ikstream/HTW-Smart-Sportswear-Prj-SS2020/Readme.md

# Repository for the Smart Sport Shirt Project

## Dependencies
- TinyGP++ Library
- ESP32 TTGO T-Beam library from espressif

## Components
This Project uses the TTGO T-Beam v1.1

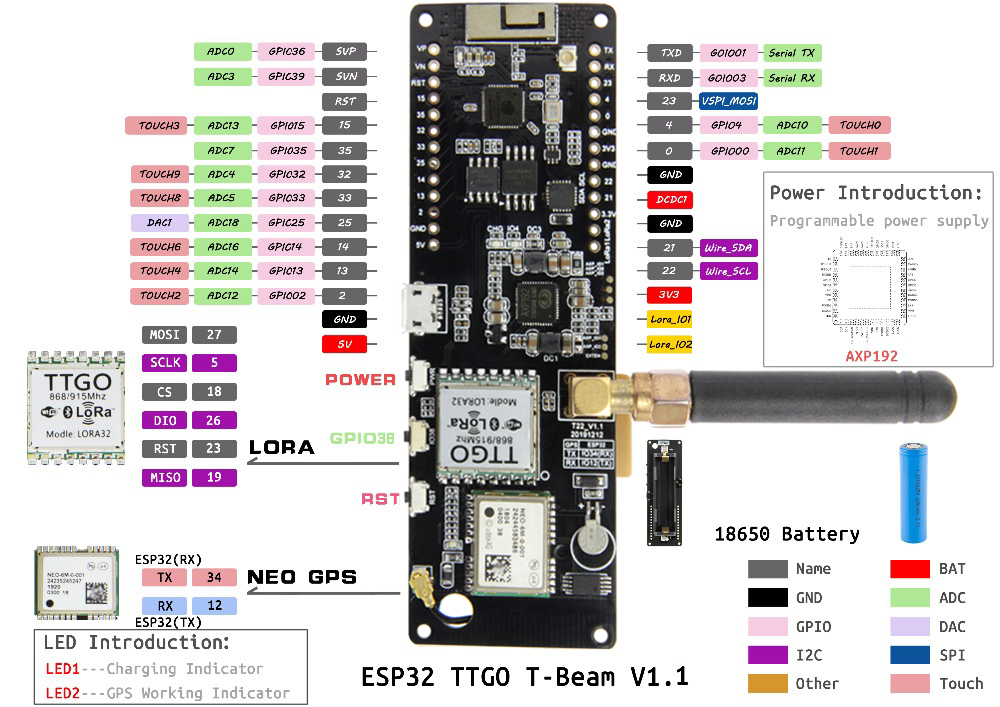
[picture p1: images/ttgo_t-beam_v1_1.jpeg]


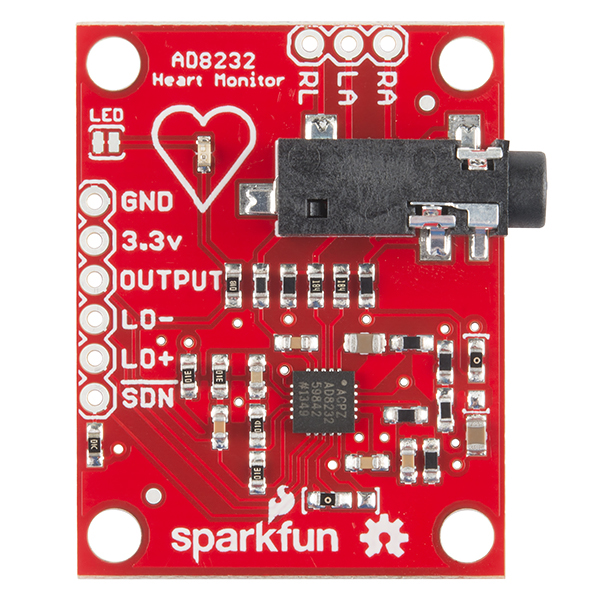
[picture p2: images/AD8232.jpg]


| T-Beam | AD8232 |
| -- 	 | --	  |
| VP 	 | Output |
| 15 	 | LO+	  |
| 35 	 | LO-	  |
| - | SDN |

And a AD8232 ECG Sensor
