ikstream/HTW-Smart-Sportswear-Prj-SS2020/images/test_vs_constructed.png

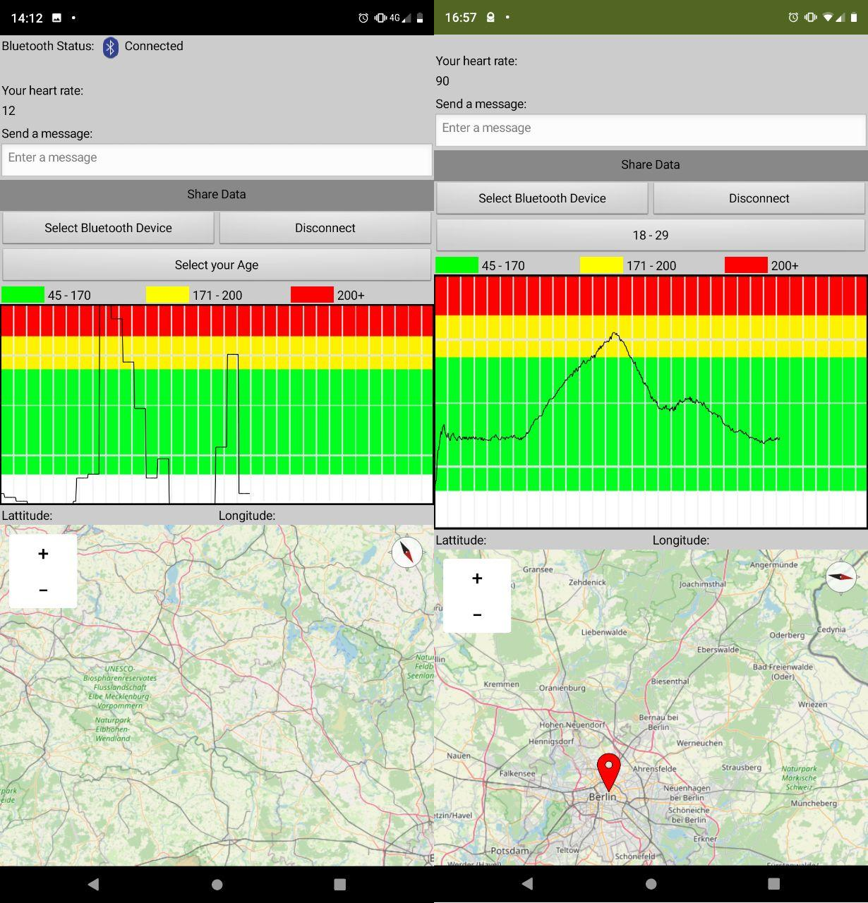
images/test_vs_constructed.png
