ikstream/HTW-Smart-Sportswear-Prj-SS2020/docs/Test_protocolls/Protokoll_Test1.md

Test Protokoll 1

# Test Protokoll 1

### Durchführung
- Schutzfolie wird von EKG-Elektroden entfernt
- AD8232 wird mit Elektroden verbunden
- T-Beam wird angeschlossen
- Test Person legt das Shirt mit Verbauter Elektronik an.
- Elektroden werden leicht angedrückt durch Testperson
- T-Beam wird mit Android App verbunden
- Versuchsperson Joggt für ca 2 Minuten

### Ergebnisse
- Keine Puls Werte angezeigt 
- GPS hat keinen ausreichenden Daten zur Positionsbestimmung

### Problemsuche
- Zusätzliche Ausgabe von Messwerten an Serielle Konsole
- Keine Messwerte von AD8232
	- Überprüfung aller Verbindungen.
	- Steckverbindung zu Elektroden hatte sich, vermutlich beim Anziehen, gelöst
