ikstream/HTW-Smart-Sportswear-Prj-SS2020/docs/Test_protocolls/Protokoll_Test2.md

Test Protokoll 2

# Test Protokoll 2

### Durchführung

- Testperson trägt Shirt
- UC ist verbunden mit Android App
- Kleber der Elektroden lässt nach
- Elektroden werden zusätzlich angefeuchtet, für bessere Leitfähigkeit
- Testperson joggt für ca 4 Minuten auf Teststrecke

### Ergebnisse 
- Messwerte des AD8232 ungenau
- Anderes Material als Elektroden Material notwendig
    - Wiederverwendbarkeit + Waschbarkeit
    - Vergleiche Material Brustgurt für Pulsuhr
- GPS kam Position nicht bestimmen
- Messwerte des AD8232 komplett abwägig im weiteren Verlauf
- Pulskurve wird mit falschen Messwerten in App angezeigt
- Messwerte werden in Datei gespeichert, die über weitere Apps geteilt werden kann

### Problemsuche
- Veränderung der Bestimmung des Pulses alle 15 Sekunden
- Veränderung des Grenzwertes für Spitzendetektion in beide Richtungen zeigen nur kurz positive Ergebnisse
