ikstream/HTW-Smart-Sportswear-Prj-SS2020/docs/Test_protocolls/Protokoll_Test3.md

Test Protokoll 3

# Test Protokoll 3

### Durchführung
- Testperson trägt Shirt
- UC mit Android App verbunden
- Elektroden zusätzlich angefeuchtet zur besseren Leitfähigkeit
- Testperson joggt ca 1 Minute
- Testperson macht 'inclined Pushups' ca 45 Sekunden

### Ergebnisse
- AD8232 liefert durchgehend Werte
    - Werte jedoch nur sporadisch realistisch
- Keine Positionsbestimmung über GPS möglich
- Pulskurve wird mit Messwerten angezeigt
- Schwellwert für Spitzendetektion scheint im Moment richtig gewählt

### Problemsuche
Versuch 3, “nass”::
Rebekka läuft ca. 1 Minuten, 
Werte wurden angepasst. 
Herz: es gab wohl vernünftige Messwerte. (Screenshot BILD)
“Ultra sensibel” eingestellt.
Versuch: Rebekka macht Liegestütze
Herz: nichts geändert ... Schwerkraft (?) der Sensoren weil Liegestütze, somit nicht mehr nah genug am Körper?
Verzögerung, wieder kommen Werte an das Handy. Kurve wird gezeichnet 

→ Werte angeben für das Protokoll. Welche Angaben wurden von uns bestimmt etc. 
 
Fazit: eventuell Herz-Sensoren falsch platziert für den Oberkörper? Angefeuchtet sinnvoll (Werte wurden ja verfälscht)?
