ikstream/HTW-Smart-Sportswear-Prj-SS2020/images/test_data_2020-09-18_14-14-14.jpg

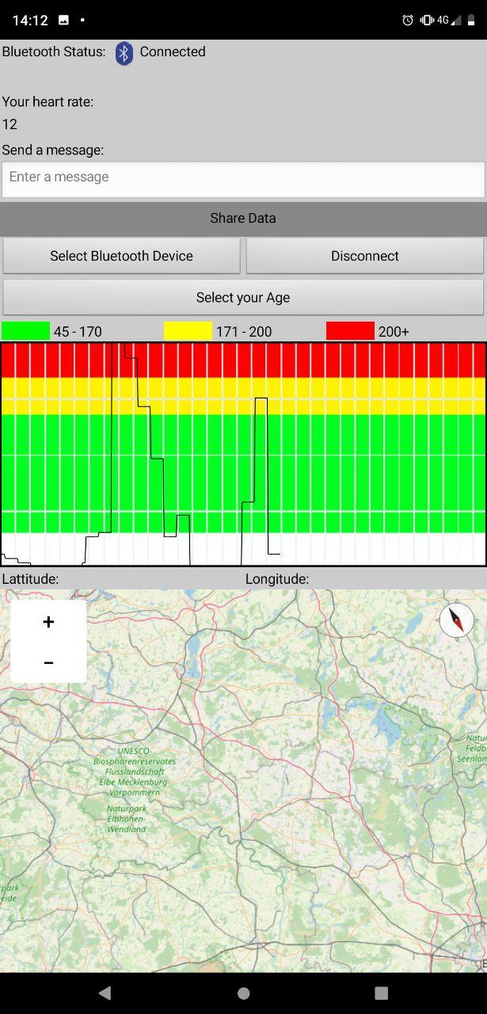
images/test_data_2020-09-18_14-14-14.jpg
